dnbdmr/67key-hardware/layout/keyboard-layout.png

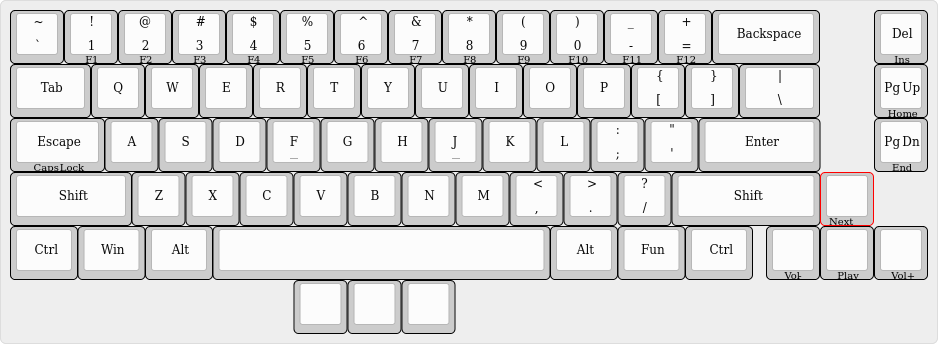
layout/keyboard-layout.png
