dnbdmr/67key-hardware/layout/keyboard-layout_details.png

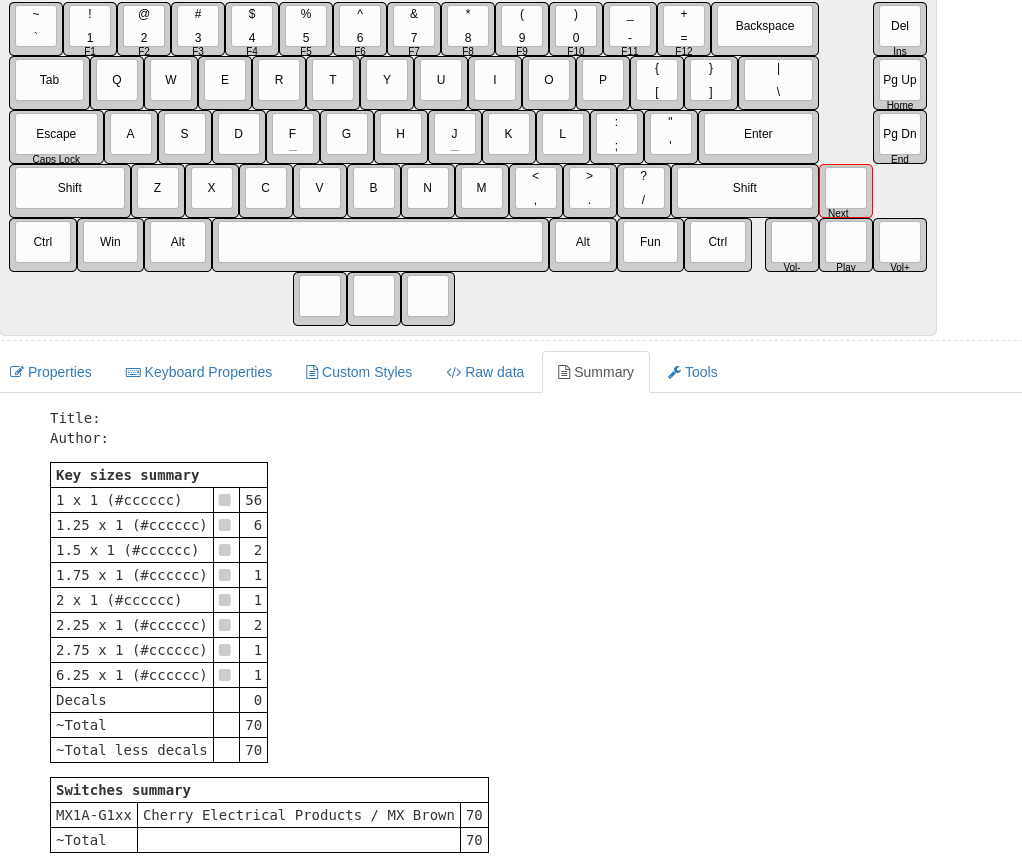
layout/keyboard-layout_details.png
