dnbdmr/67key-hardware/67keys-trackpoint.kicad_pcb

## KiCad design 67keys-trackpoint.kicad_pcb (2020-06-23)

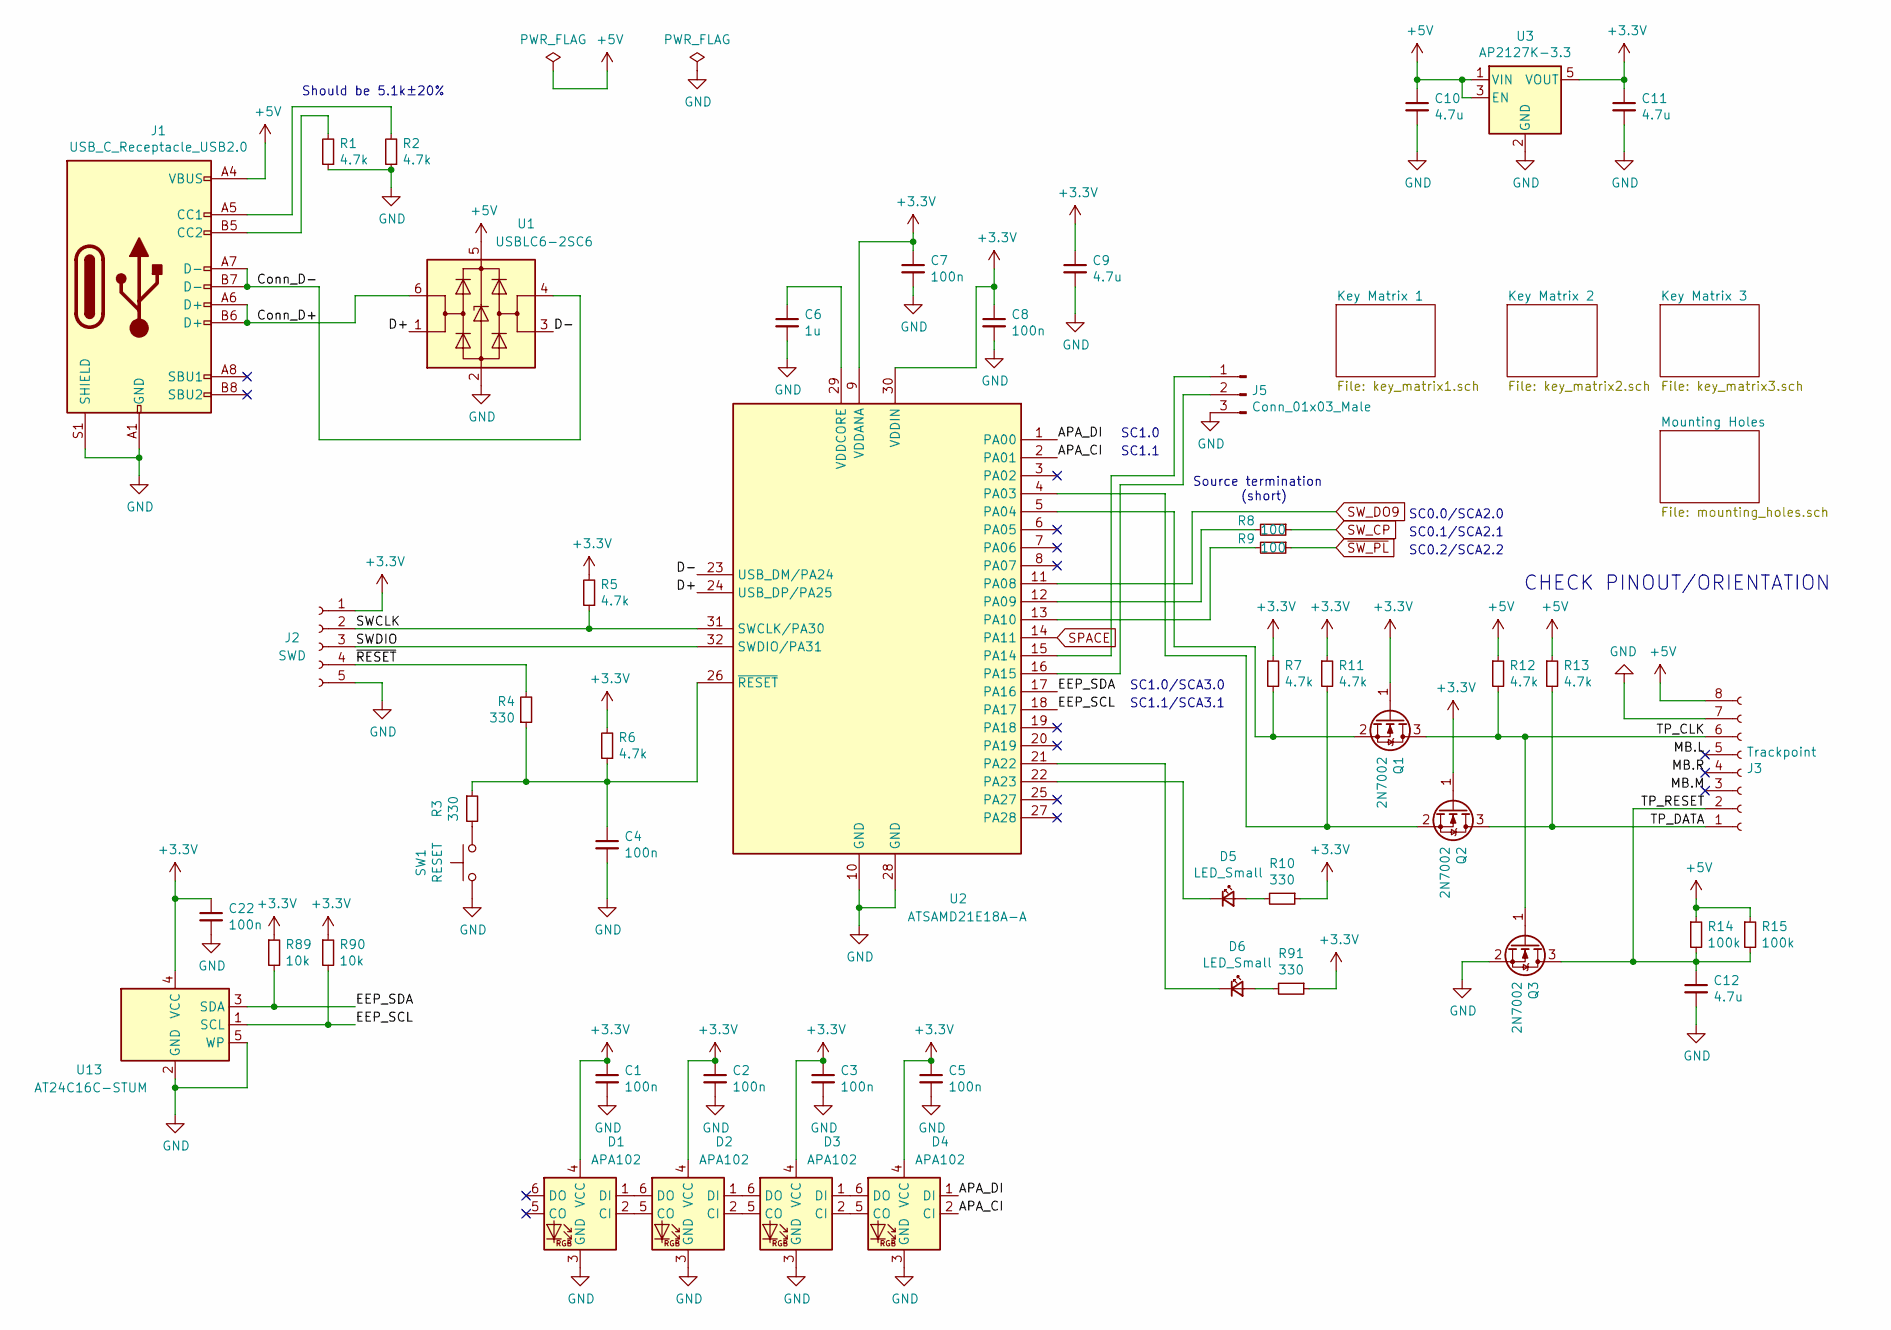
[picture p3: schematic 67keys-trackpoint.sch, 67 Keyboard with Trackpoint]

Parts:
C1, C2, C3, C4, C5, C7, C8, C22: 100n; C_0603_1608Metric_Pad1.05x0.95mm_HandSolder
C6: 1u; C_0603_1608Metric_Pad1.05x0.95mm_HandSolder
C9, C10, C11, C12: 4.7u; C_0603_1608Metric_Pad1.05x0.95mm_HandSolder
D1, D2, D3, D4: APA102; LED_RGB_5050-6
D5, D6: LED_Small; LED_0805_2012Metric_Pad1.15x1.40mm_HandSolder
J1: USB_C_Receptacle_USB2.0; USB_C_Receptacle_GCT_USB4085
J2: SWD; PinHeader_1x05_P2.54mm_Vertical
J3: Trackpoint; TE_84952-8_1x08-1MP_P1.0mm_Horizontal
J5: Conn_01x03_Male; PinHeader_1x03_P2.54mm_Vertical
Q1, Q2, Q3: 2N7002; SOT-23
R1, R2, R5, R6, R7, R11, R12, R13: 4.7k; R_0603_1608Metric_Pad1.05x0.95mm_HandSolder
R3, R4, R10, R91: 330; R_0603_1608Metric_Pad1.05x0.95mm_HandSolder
R8, R9: 100; R_0603_1608Metric_Pad1.05x0.95mm_HandSolder
R14, R15: 100k; R_0603_1608Metric_Pad1.05x0.95mm_HandSolder
R89, R90: 10k; R_0603_1608Metric_Pad1.05x0.95mm_HandSolder
SW1: RESET; SW_SPST_TL3305A
U1: USBLC6-2SC6; SOT-23-6
U2: ATSAMD21E18A-A; TQFP-32_7x7mm_P0.8mm
U3: AP2127K-3.3; SOT-23-5
U13: AT24C16C-STUM; SOT-23-5

Connections:
+3V3: C1.1, C2.1, C3.1, C5.1, C7.1, C8.1, C9.1, C11.1, C22.1, D1.4 (VCC), D2.4 (VCC), D3.4 (VCC), D4.4 (VCC), J2.1, Q1.1 (G), Q2.1 (G), R5.2, R6.2, R7.1, R10.1, R11.1, R89.1, R90.1, R91.1, U2.9 (VDDANA), U2.30 (VDDIN), U3.5 (VOUT), U13.4 (VCC); also elsewhere on the board
+5V: C10.1, J1.A4 (VBUS), J1.A9 (VBUS), J1.B4 (VBUS), J1.B9 (VBUS), J3.8, R12.1, R13.1, R14.1, R15.1, U1.5 (VBUS), U3.1 (VIN), U3.3 (EN)
/APA_CI: D4.2 (CI), U2.2 (PA01)
/APA_DI: D4.1 (DI), U2.1 (PA00)
/Conn_D+: J1.A6 (D+), J1.B6 (D+), U1.6 (I/O1)
/Conn_D-: J1.A7 (D-), J1.B7 (D-), U1.4 (I/O2)
/D+: U1.1 (I/O1), U2.24 (USB_DP/PA25)
/D-: U1.3 (I/O2), U2.23 (USB_DM/PA24)
/EEP_SCL: R90.2, U2.18 (PA17), U13.1 (SCL)
/EEP_SDA: R89.2, U2.17 (PA16), U13.3 (SDA)
/SWCLK: J2.2, R5.1, U2.31 (SWCLK/PA30)
/SWDIO: J2.3, U2.32 (SWDIO/PA31)
/TP_CLK: J3.6, Q1.3 (D), Q3.1 (G), R12.2
/TP_DATA: J3.1, Q2.3 (D), R13.2
/TP_RESET: C12.1, J3.2, Q3.3 (D), R14.2, R15.2
/~RESET: J2.4, R4.2
GND: C1.2, C2.2, C3.2, C4.2, C5.2, C6.2, C7.2, C8.2, C9.2, C10.2, C11.2, C12.2, C22.2, D1.3 (GND), D2.3 (GND), D3.3 (GND), D4.3 (GND), J1.A1 (GND), J1.A12 (GND), J1.B1 (GND), J1.B12 (GND), J1.S1 (SHIELD), J2.5, J3.7, J5.3, Q3.2 (S), R1.1, R2.1, SW1.1, U1.2 (GND), U2.10 (GND), U2.28 (GND), U3.2 (GND), U13.2 (GND), U13.5 (WP); also elsewhere on the board
unnamed: C4.1, R3.1, R4.1, R6.1, U2.26 (~RESET)
unnamed: C6.1, U2.29 (VDDCORE)
unnamed: D1.1 (DI), D2.6 (DO)
unnamed: D1.2 (CI), D2.5 (CO)
unnamed: D2.1 (DI), D3.6 (DO)
unnamed: D2.2 (CI), D3.5 (CO)
unnamed: D3.1 (DI), D4.6 (DO)
unnamed: D3.2 (CI), D4.5 (CO)
unnamed: D5.1 (K), U2.22 (PA23)
unnamed: D5.2 (A), R10.2
unnamed: D6.1 (K), U2.21 (PA22)
unnamed: D6.2 (A), R91.2
unnamed: J1.A5 (CC1), R2.2
unnamed: J1.B5 (CC2), R1.2
unnamed: J5.1, U2.15 (PA14)
unnamed: J5.2, U2.16 (PA15)
unnamed: Q1.2 (S), R7.2, U2.5 (PA04)
unnamed: Q2.2 (S), R11.2, U2.4 (PA03)
unnamed: R3.2, SW1.2
unnamed: R8.2, U2.12 (PA09)
unnamed: R9.2, U2.13 (PA10)
SPACE: U2.14 (PA11); also elsewhere on the board
SW_CP: R8.1; also elsewhere on the board
SW_DO9: U2.11 (PA08); also elsewhere on the board
~SW_PL: R9.1; also elsewhere on the board

Notes on the sheet:
CHECK PINOUT/ORIENTATION
Should be 5.1k±20%
Source termination (short)
SC1.0
SC1.1
SC0.1/SCA2.1
SC0.2/SCA2.2
SC1.1/SCA3.1
SC1.0/SCA3.0
SC0.0/SCA2.0

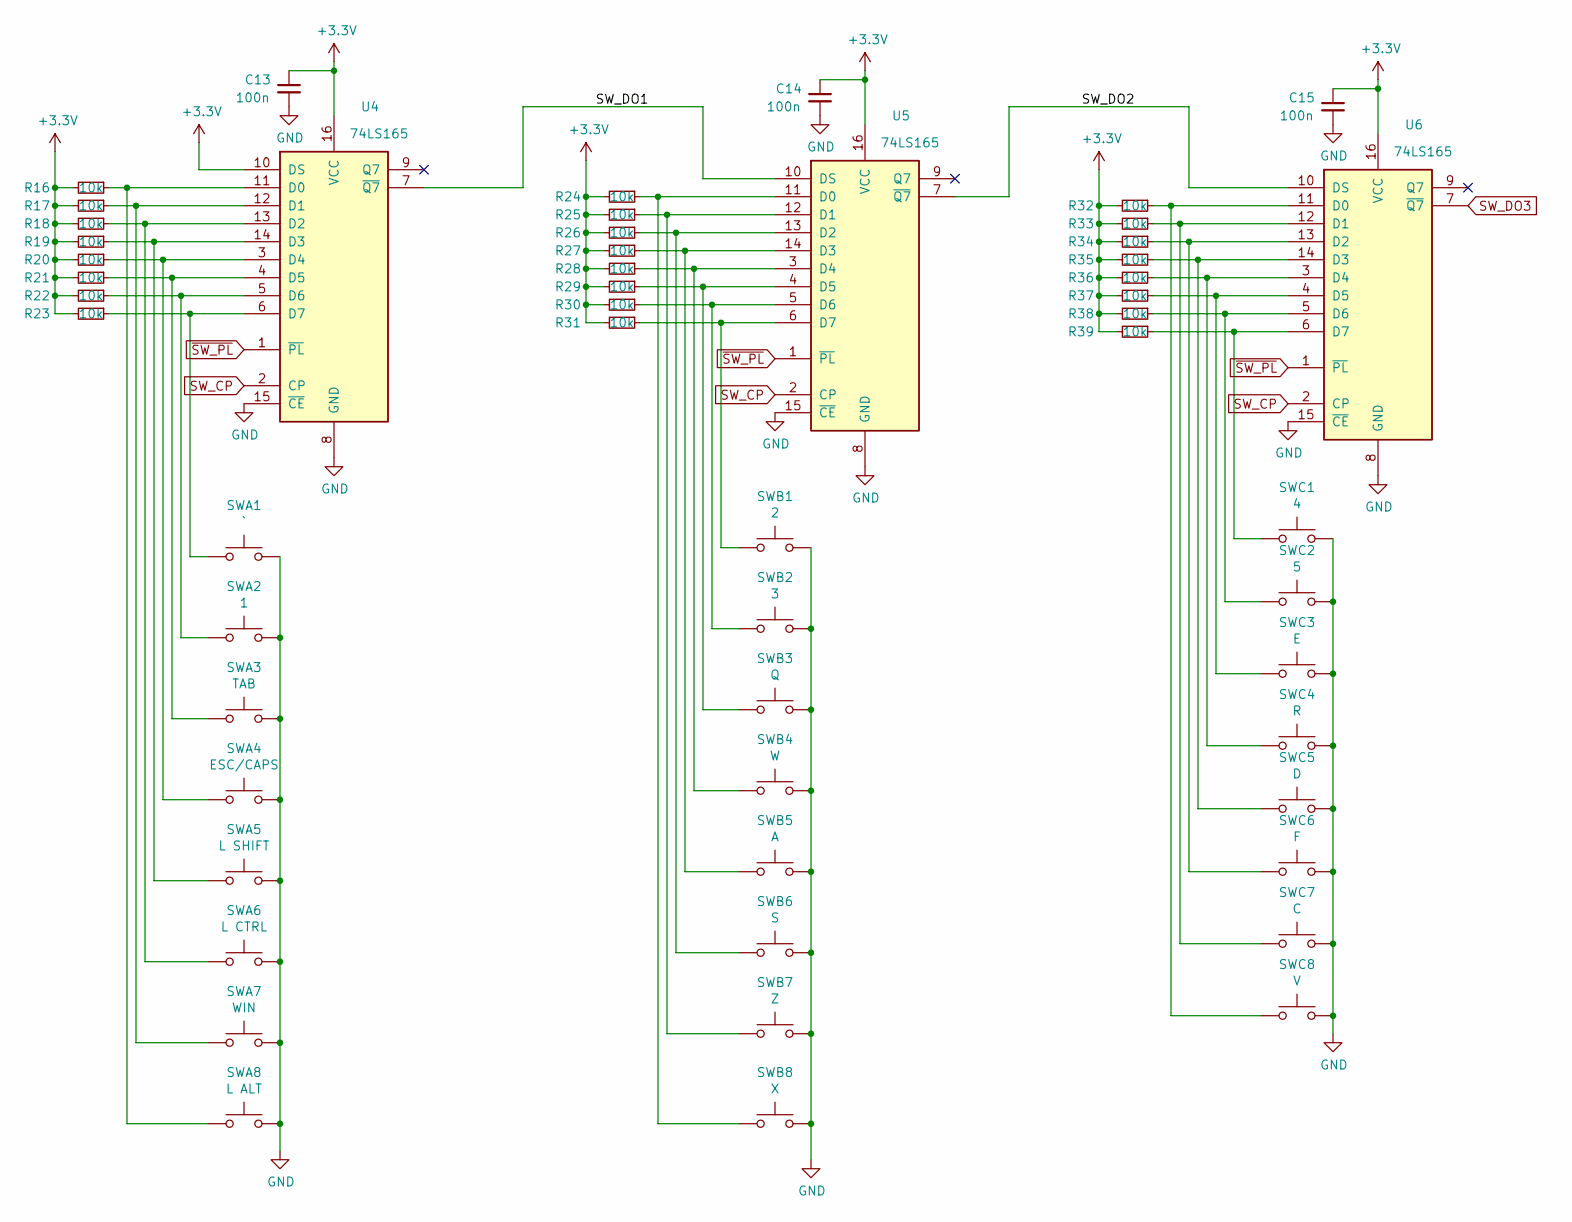
[picture p4: schematic key_matrix1.sch, 67 Keyboard with Trackpoint]

Parts:
C13, C14, C15: 100n; C_0603_1608Metric_Pad1.05x0.95mm_HandSolder
R16, R17, R18, R19, R20, R21, R22, R23, R24, R25, R26, R27, R28, R29, R30, R31, R32, R33, R34, R35, R36, R37, R38, R39: 10k; R_0603_1608Metric_Pad1.05x0.95mm_HandSolder
SWA1: `; SW_Cherry_MX_1.00u_PCB
SWA2: 1; SW_Cherry_MX_1.00u_PCB
SWA3: TAB; SW_Cherry_MX_1.50u_PCB
SWA4: ESC/CAPS; SW_Cherry_MX_1.75u_PCB
SWA5: L SHIFT; SW_Cherry_MX_2.25u_PCB
SWA6: L CTRL; SW_Cherry_MX_1.25u_PCB
SWA7: WIN; SW_Cherry_MX_1.25u_PCB
SWA8: L ALT; SW_Cherry_MX_1.25u_PCB
SWB1: 2; SW_Cherry_MX_1.00u_PCB
SWB2: 3; SW_Cherry_MX_1.00u_PCB
SWB3: Q; SW_Cherry_MX_1.00u_PCB
SWB4: W; SW_Cherry_MX_1.00u_PCB
SWB5: A; SW_Cherry_MX_1.00u_PCB
SWB6: S; SW_Cherry_MX_1.00u_PCB
SWB7: Z; SW_Cherry_MX_1.00u_PCB
SWB8: X; SW_Cherry_MX_1.00u_PCB
SWC1: 4; SW_Cherry_MX_1.00u_PCB
SWC2: 5; SW_Cherry_MX_1.00u_PCB
SWC3: E; SW_Cherry_MX_1.00u_PCB
SWC4: R; SW_Cherry_MX_1.00u_PCB
SWC5: D; SW_Cherry_MX_1.00u_PCB
SWC6: F; SW_Cherry_MX_1.00u_PCB
SWC7: C; SW_Cherry_MX_1.00u_PCB
SWC8: V; SW_Cherry_MX_1.00u_PCB
U4, U5, U6: 74LS165; TSSOP-16_4.4x5mm_P0.65mm

Connections:
+3V3: C13.1, C14.1, C15.1, R16.2, R17.2, R18.2, R19.2, R20.2, R21.2, R22.2, R23.2, R24.2, R25.2, R26.2, R27.2, R28.2, R29.2, R30.2, R31.2, R32.2, R33.2, R34.2, R35.2, R36.2, R37.2, R38.2, R39.2, U4.10 (DS), U4.16 (VCC), U5.16 (VCC), U6.16 (VCC); also elsewhere on the board
/Key Matrix 1/SW_DO1: U4.7 (~Q7), U5.10 (DS)
/Key Matrix 1/SW_DO2: U5.7 (~Q7), U6.10 (DS)
GND: C13.2, C14.2, C15.2, SWA1.2, SWA2.2, SWA3.2, SWA4.2, SWA5.2, SWA6.2, SWA7.2, SWA8.2, SWB1.2, SWB2.2, SWB3.2, SWB4.2, SWB5.2, SWB6.2, SWB7.2, SWB8.2, SWC1.2, SWC2.2, SWC3.2, SWC4.2, SWC5.2, SWC6.2, SWC7.2, SWC8.2, U4.8 (GND), U4.15 (~CE), U5.8 (GND), U5.15 (~CE), U6.8 (GND), U6.15 (~CE); also elsewhere on the board
unnamed: R16.1, SWA8.1, U4.11 (D0)
unnamed: R17.1, SWA7.1, U4.12 (D1)
unnamed: R18.1, SWA6.1, U4.13 (D2)
unnamed: R19.1, SWA5.1, U4.14 (D3)
unnamed: R20.1, SWA4.1, U4.3 (D4)
unnamed: R21.1, SWA3.1, U4.4 (D5)
unnamed: R22.1, SWA2.1, U4.5 (D6)
unnamed: R23.1, SWA1.1, U4.6 (D7)
unnamed: R24.1, SWB8.1, U5.11 (D0)
unnamed: R25.1, SWB7.1, U5.12 (D1)
unnamed: R26.1, SWB6.1, U5.13 (D2)
unnamed: R27.1, SWB5.1, U5.14 (D3)
unnamed: R28.1, SWB4.1, U5.3 (D4)
unnamed: R29.1, SWB3.1, U5.4 (D5)
unnamed: R30.1, SWB2.1, U5.5 (D6)
unnamed: R31.1, SWB1.1, U5.6 (D7)
unnamed: R32.1, SWC8.1, U6.11 (D0)
unnamed: R33.1, SWC7.1, U6.12 (D1)
unnamed: R34.1, SWC6.1, U6.13 (D2)
unnamed: R35.1, SWC5.1, U6.14 (D3)
unnamed: R36.1, SWC4.1, U6.3 (D4)
unnamed: R37.1, SWC3.1, U6.4 (D5)
unnamed: R38.1, SWC2.1, U6.5 (D6)
unnamed: R39.1, SWC1.1, U6.6 (D7)
SW_CP: U4.2 (CP), U5.2 (CP), U6.2 (CP); also elsewhere on the board
SW_DO3: U6.7 (~Q7); also elsewhere on the board
~SW_PL: U4.1 (~PL), U5.1 (~PL), U6.1 (~PL); also elsewhere on the board

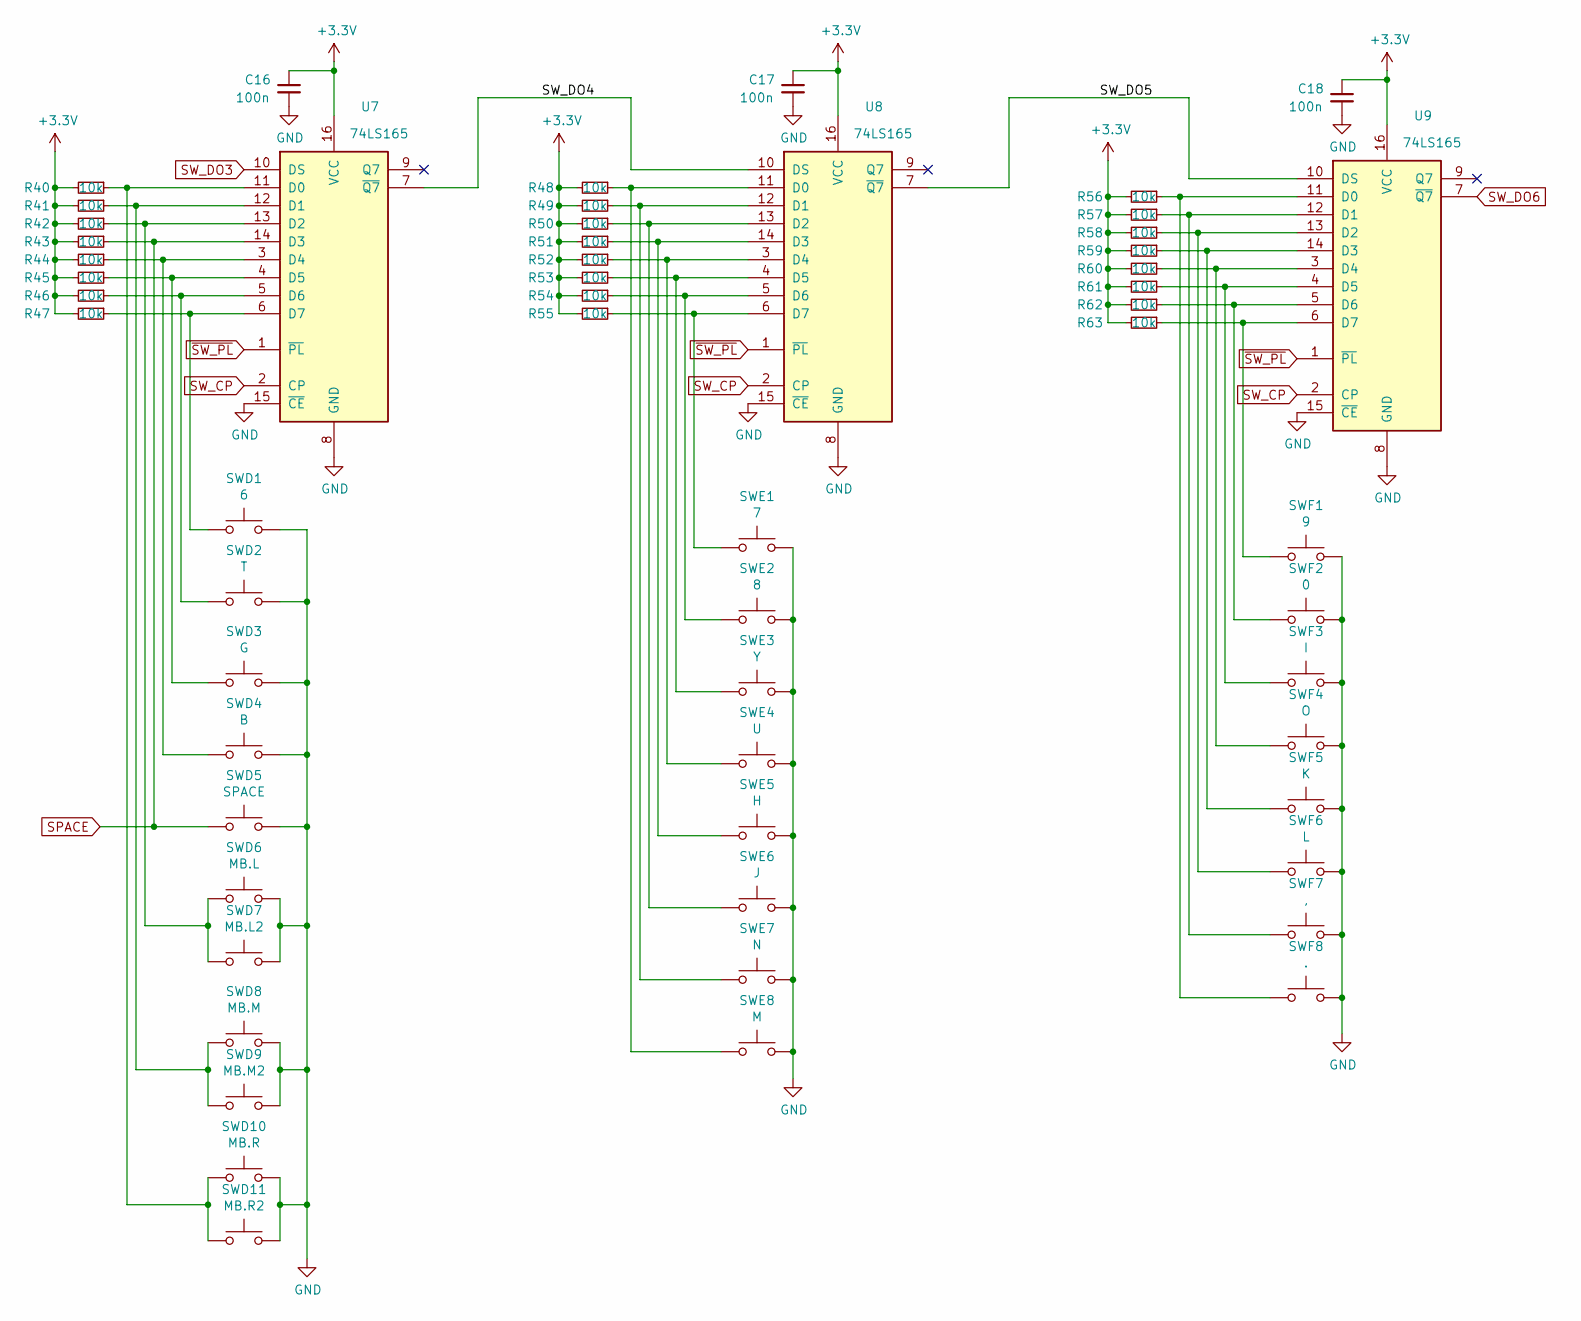
[picture p5: schematic key_matrix2.sch, 67 Keyboard with Trackpoint]

Parts:
C16, C17, C18: 100n; C_0603_1608Metric_Pad1.05x0.95mm_HandSolder
R40, R41, R42, R43, R44, R45, R46, R47, R48, R49, R50, R51, R52, R53, R54, R55, R56, R57, R58, R59, R60, R61, R62, R63: 10k; R_0603_1608Metric_Pad1.05x0.95mm_HandSolder
SWD1: 6; SW_Cherry_MX_1.00u_PCB
SWD2: T; SW_Cherry_MX_1.00u_PCB
SWD3: G; SW_Cherry_MX_1.00u_PCB
SWD4: B; SW_Cherry_MX_1.00u_PCB
SWD5: SPACE; SW_Cherry_MX_6.25u_PCB
SWD6: MB.L; SW_Cherry_MX_1.00u_PCB
SWD7: MB.L2; SW_Tactile_SPST_Angled_PTS645Vx58-2LFS
SWD8: MB.M; SW_Cherry_MX_1.00u_PCB
SWD9: MB.M2; SW_Tactile_SPST_Angled_PTS645Vx58-2LFS
SWD10: MB.R; SW_Cherry_MX_1.00u_PCB
SWD11: MB.R2; SW_Tactile_SPST_Angled_PTS645Vx58-2LFS
SWE1: 7; SW_Cherry_MX_1.00u_PCB
SWE2: 8; SW_Cherry_MX_1.00u_PCB
SWE3: Y; SW_Cherry_MX_1.00u_PCB
SWE4: U; SW_Cherry_MX_1.00u_PCB
SWE5: H; SW_Cherry_MX_1.00u_PCB
SWE6: J; SW_Cherry_MX_1.00u_PCB
SWE7: N; SW_Cherry_MX_1.00u_PCB
SWE8: M; SW_Cherry_MX_1.00u_PCB
SWF1: 9; SW_Cherry_MX_1.00u_PCB
SWF2: 0; SW_Cherry_MX_1.00u_PCB
SWF3: I; SW_Cherry_MX_1.00u_PCB
SWF4: O; SW_Cherry_MX_1.00u_PCB
SWF5: K; SW_Cherry_MX_1.00u_PCB
SWF6: L; SW_Cherry_MX_1.00u_PCB
SWF7: ,; SW_Cherry_MX_1.00u_PCB
SWF8: .; SW_Cherry_MX_1.00u_PCB
U7, U8, U9: 74LS165; TSSOP-16_4.4x5mm_P0.65mm

Connections:
+3V3: C16.1, C17.1, C18.1, R40.2, R41.2, R42.2, R43.2, R44.2, R45.2, R46.2, R47.2, R48.2, R49.2, R50.2, R51.2, R52.2, R53.2, R54.2, R55.2, R56.2, R57.2, R58.2, R59.2, R60.2, R61.2, R62.2, R63.2, U7.16 (VCC), U8.16 (VCC), U9.16 (VCC); also elsewhere on the board
/Key Matrix 2/SW_DO4: U7.7 (~Q7), U8.10 (DS)
/Key Matrix 2/SW_DO5: U8.7 (~Q7), U9.10 (DS)
GND: C16.2, C17.2, C18.2, SWD1.2, SWD2.2, SWD3.2, SWD4.2, SWD5.2, SWD6.2, SWD7.2, SWD8.2, SWD9.2, SWD10.2, SWD11.2, SWE1.2, SWE2.2, SWE3.2, SWE4.2, SWE5.2, SWE6.2, SWE7.2, SWE8.2, SWF1.2, SWF2.2, SWF3.2, SWF4.2, SWF5.2, SWF6.2, SWF7.2, SWF8.2, U7.8 (GND), U7.15 (~CE), U8.8 (GND), U8.15 (~CE), U9.8 (GND), U9.15 (~CE); also elsewhere on the board
unnamed: R40.1, SWD10.1, SWD11.1, U7.11 (D0)
unnamed: R41.1, SWD8.1, SWD9.1, U7.12 (D1)
unnamed: R42.1, SWD6.1, SWD7.1, U7.13 (D2)
unnamed: R44.1, SWD4.1, U7.3 (D4)
unnamed: R45.1, SWD3.1, U7.4 (D5)
unnamed: R46.1, SWD2.1, U7.5 (D6)
unnamed: R47.1, SWD1.1, U7.6 (D7)
unnamed: R48.1, SWE8.1, U8.11 (D0)
unnamed: R49.1, SWE7.1, U8.12 (D1)
unnamed: R50.1, SWE6.1, U8.13 (D2)
unnamed: R51.1, SWE5.1, U8.14 (D3)
unnamed: R52.1, SWE4.1, U8.3 (D4)
unnamed: R53.1, SWE3.1, U8.4 (D5)
unnamed: R54.1, SWE2.1, U8.5 (D6)
unnamed: R55.1, SWE1.1, U8.6 (D7)
unnamed: R56.1, SWF8.1, U9.11 (D0)
unnamed: R57.1, SWF7.1, U9.12 (D1)
unnamed: R58.1, SWF6.1, U9.13 (D2)
unnamed: R59.1, SWF5.1, U9.14 (D3)
unnamed: R60.1, SWF4.1, U9.3 (D4)
unnamed: R61.1, SWF3.1, U9.4 (D5)
unnamed: R62.1, SWF2.1, U9.5 (D6)
unnamed: R63.1, SWF1.1, U9.6 (D7)
SPACE: R43.1, SWD5.1, U7.14 (D3); also elsewhere on the board
SW_CP: U7.2 (CP), U8.2 (CP), U9.2 (CP); also elsewhere on the board
SW_DO3: U7.10 (DS); also elsewhere on the board
SW_DO6: U9.7 (~Q7); also elsewhere on the board
~SW_PL: U7.1 (~PL), U8.1 (~PL), U9.1 (~PL); also elsewhere on the board

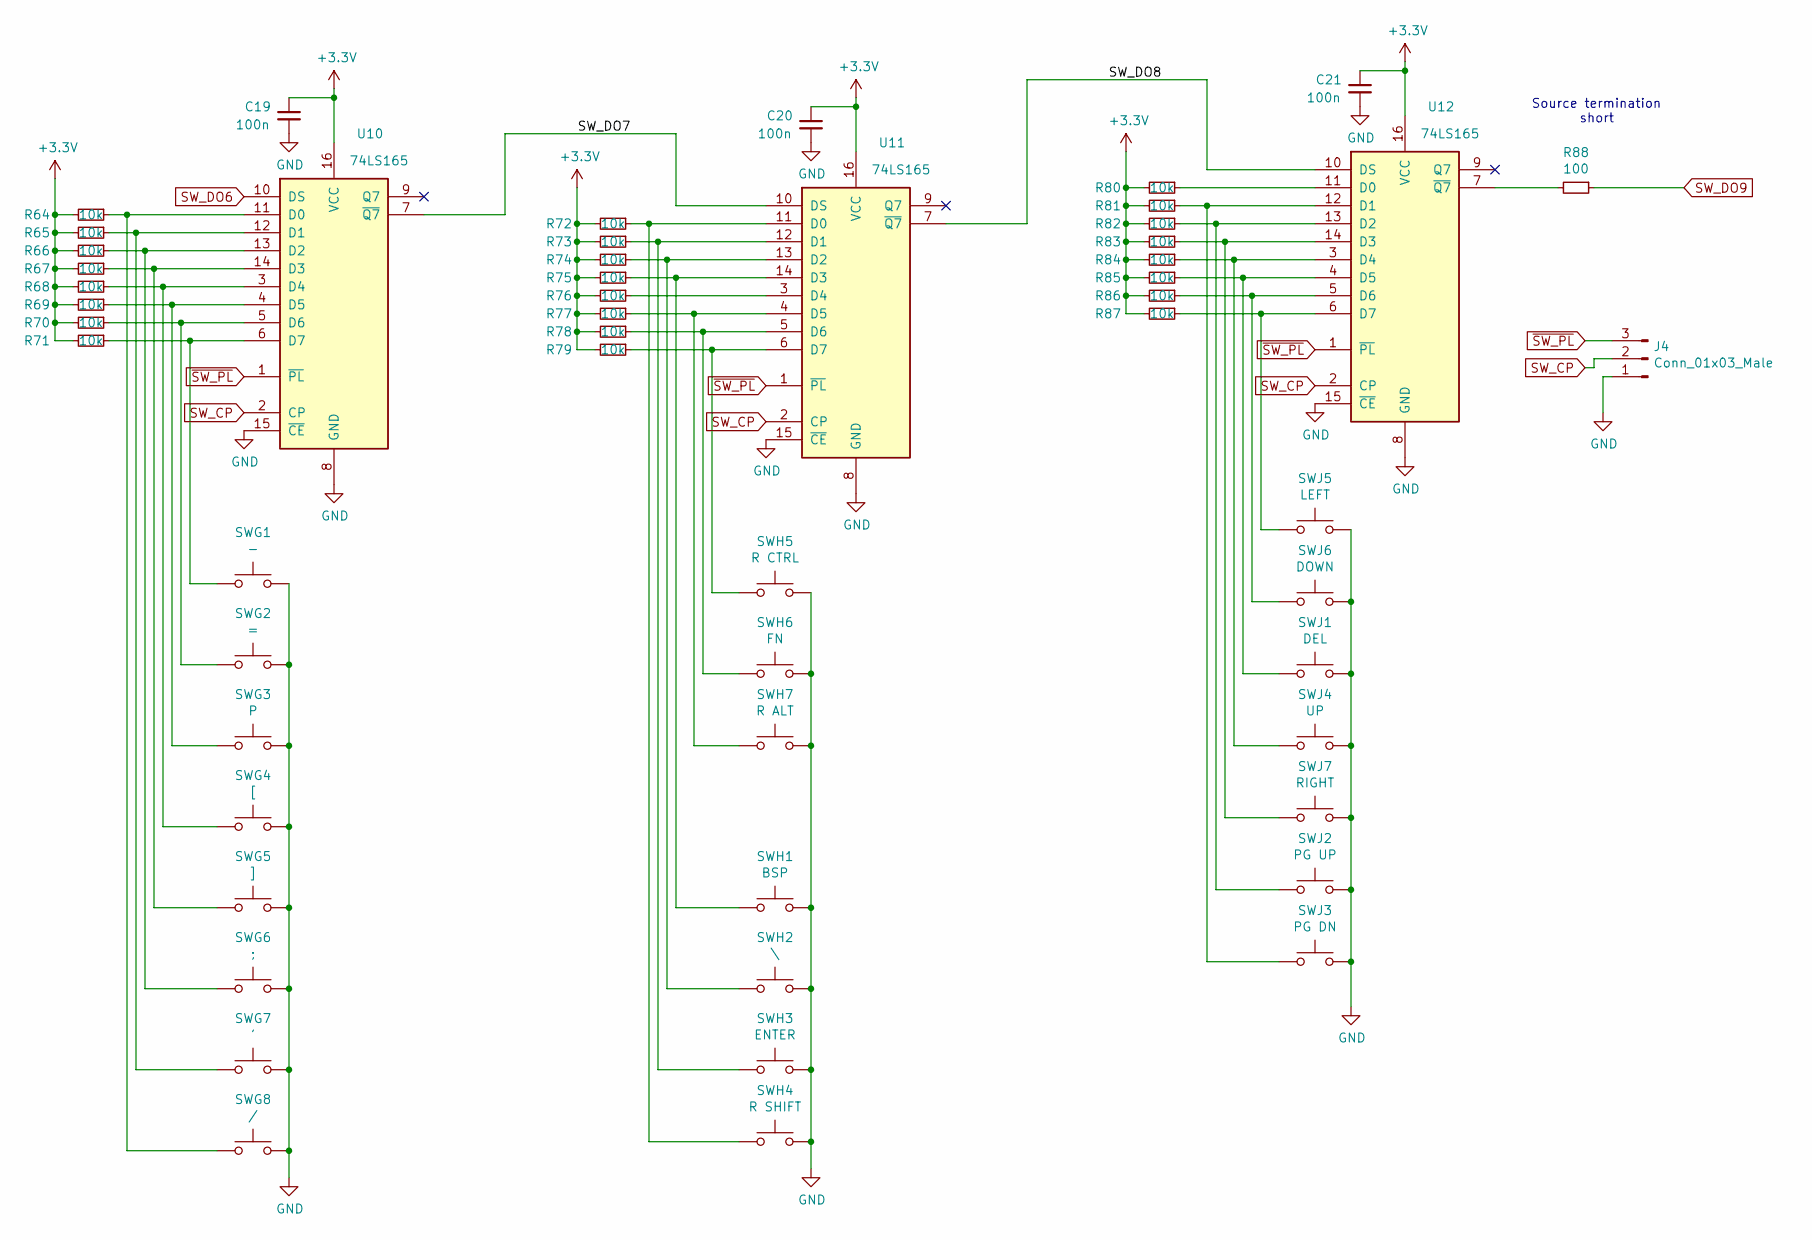
[picture p6: schematic key_matrix3.sch, 67 Keyboard with Trackpoint]

Parts:
C19, C20, C21: 100n; C_0603_1608Metric_Pad1.05x0.95mm_HandSolder
J4: Conn_01x03_Male; PinHeader_1x03_P2.54mm_Vertical
R64, R65, R66, R67, R68, R69, R70, R71, R72, R73, R74, R75, R76, R77, R78, R79, R80, R81, R82, R83, R84, R85, R86, R87: 10k; R_0603_1608Metric_Pad1.05x0.95mm_HandSolder
R88: 100; R_0603_1608Metric_Pad1.05x0.95mm_HandSolder
SWG1: -; SW_Cherry_MX_1.00u_PCB
SWG2: =; SW_Cherry_MX_1.00u_PCB
SWG3: P; SW_Cherry_MX_1.00u_PCB
SWG4: [; SW_Cherry_MX_1.00u_PCB
SWG5: ]; SW_Cherry_MX_1.00u_PCB
SWG6: ;; SW_Cherry_MX_1.00u_PCB
SWG7: '; SW_Cherry_MX_1.00u_PCB
SWG8: /; SW_Cherry_MX_1.00u_PCB
SWH1: BSP; SW_Cherry_MX_2.00u_PCB
SWH2: \\; SW_Cherry_MX_1.50u_PCB
SWH3: ENTER; SW_Cherry_MX_2.25u_PCB
SWH4: R SHIFT; SW_Cherry_MX_2.75u_PCB
SWH5: R CTRL; SW_Cherry_MX_1.25u_PCB
SWH6: FN; SW_Cherry_MX_1.25u_PCB
SWH7: R ALT; SW_Cherry_MX_1.25u_PCB
SWJ1: DEL; SW_Cherry_MX_1.00u_PCB
SWJ2: PG UP; SW_Cherry_MX_1.00u_PCB
SWJ3: PG DN; SW_Cherry_MX_1.00u_PCB
SWJ4: UP; SW_Cherry_MX_1.00u_PCB
SWJ5: LEFT; SW_Cherry_MX_1.00u_PCB
SWJ6: DOWN; SW_Cherry_MX_1.00u_PCB
SWJ7: RIGHT; SW_Cherry_MX_1.00u_PCB
U10, U11, U12: 74LS165; TSSOP-16_4.4x5mm_P0.65mm

Connections:
+3V3: C19.1, C20.1, C21.1, R64.2, R65.2, R66.2, R67.2, R68.2, R69.2, R70.2, R71.2, R72.2, R73.2, R74.2, R75.2, R76.2, R77.2, R78.2, R79.2, R80.2, R81.2, R82.2, R83.2, R84.2, R85.2, R86.2, R87.2, U10.16 (VCC), U11.16 (VCC), U12.16 (VCC); also elsewhere on the board
/Key Matrix 3/SW_DO7: U10.7 (~Q7), U11.10 (DS)
/Key Matrix 3/SW_DO8: U11.7 (~Q7), U12.10 (DS)
GND: C19.2, C20.2, C21.2, J4.1, SWG1.2, SWG2.2, SWG3.2, SWG4.2, SWG5.2, SWG6.2, SWG7.2, SWG8.2, SWH1.2, SWH2.2, SWH3.2, SWH4.2, SWH5.2, SWH6.2, SWH7.2, SWJ1.2, SWJ2.2, SWJ3.2, SWJ4.2, SWJ5.2, SWJ6.2, SWJ7.2, U10.8 (GND), U10.15 (~CE), U11.8 (GND), U11.15 (~CE), U12.8 (GND), U12.15 (~CE); also elsewhere on the board
unnamed: R64.1, SWG8.1, U10.11 (D0)
unnamed: R65.1, SWG7.1, U10.12 (D1)
unnamed: R66.1, SWG6.1, U10.13 (D2)
unnamed: R67.1, SWG5.1, U10.14 (D3)
unnamed: R68.1, SWG4.1, U10.3 (D4)
unnamed: R69.1, SWG3.1, U10.4 (D5)
unnamed: R70.1, SWG2.1, U10.5 (D6)
unnamed: R71.1, SWG1.1, U10.6 (D7)
unnamed: R72.1, SWH4.1, U11.11 (D0)
unnamed: R73.1, SWH3.1, U11.12 (D1)
unnamed: R74.1, SWH2.1, U11.13 (D2)
unnamed: R75.1, SWH1.1, U11.14 (D3)
unnamed: R76.1, U11.3 (D4)
unnamed: R77.1, SWH7.1, U11.4 (D5)
unnamed: R78.1, SWH6.1, U11.5 (D6)
unnamed: R79.1, SWH5.1, U11.6 (D7)
unnamed: R80.1, U12.11 (D0)
unnamed: R81.1, SWJ3.1, U12.12 (D1)
unnamed: R82.1, SWJ2.1, U12.13 (D2)
unnamed: R83.1, SWJ7.1, U12.14 (D3)
unnamed: R84.1, SWJ4.1, U12.3 (D4)
unnamed: R85.1, SWJ1.1, U12.4 (D5)
unnamed: R86.1, SWJ6.1, U12.5 (D6)
unnamed: R87.1, SWJ5.1, U12.6 (D7)
unnamed: R88.2, U12.7 (~Q7)
SW_CP: J4.2, U10.2 (CP), U11.2 (CP), U12.2 (CP); also elsewhere on the board
SW_DO6: U10.10 (DS); also elsewhere on the board
SW_DO9: R88.1; also elsewhere on the board
~SW_PL: J4.3, U10.1 (~PL), U11.1 (~PL), U12.1 (~PL); also elsewhere on the board

Notes on the sheet:
Source termination short

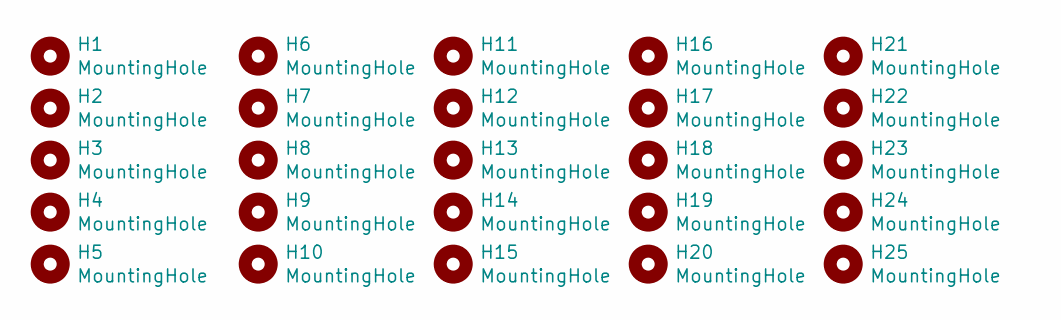
[picture p7: schematic mounting_holes.sch, 67 Keyboard with Trackpoint]

Parts:
H1, H2, H3, H4, H5, H6, H7, H8, H9, H10, H11, H12, H13, H14, H15, H16, H17, H18, H19, H20, H21, H22, H23, H24, H25: MountingHole; MountingHole_2.2mm_M2

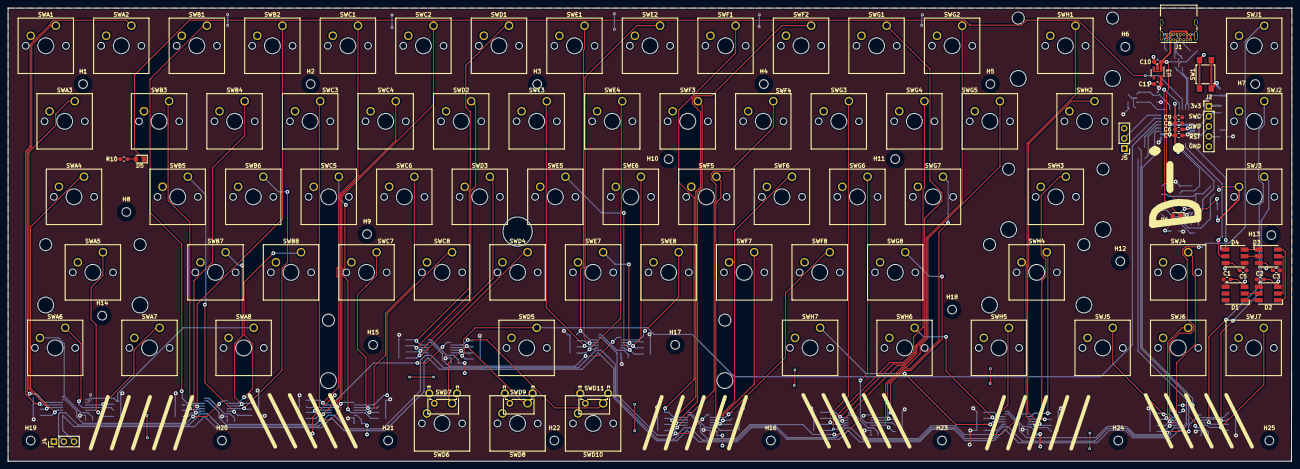
[picture p8: board 67keys-trackpoint.kicad_pcb from above]

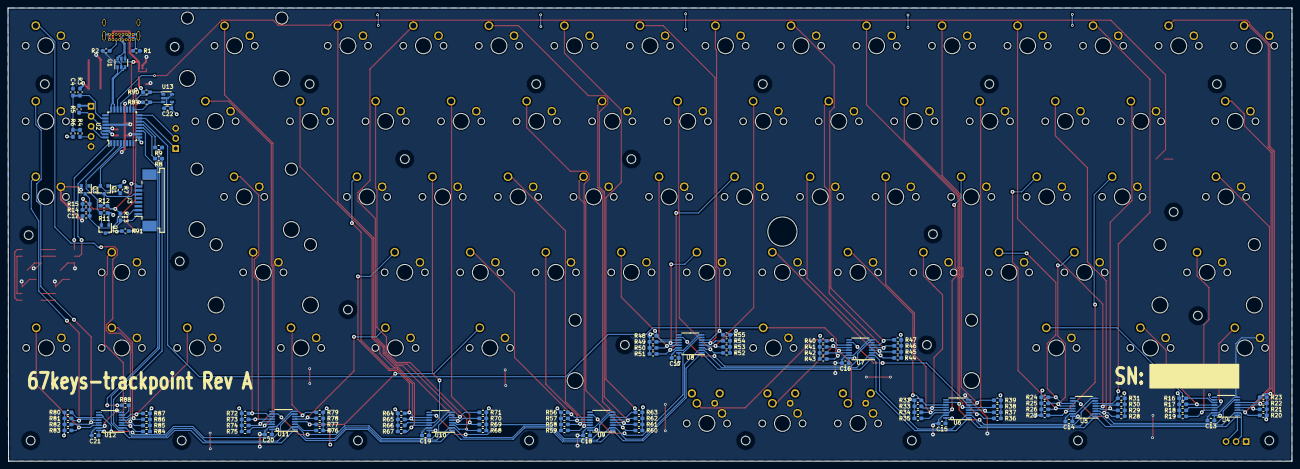
[picture p9: board 67keys-trackpoint.kicad_pcb from below]

Board: 2 copper layers, 323.9 x 114.3 mm, 239 parts (118 on the bottom side), 122 nets.
