dnbdmr/67key-hardware/(commit log)

2020-06-10 Initial commit. Mostly complete.
    [67keys-trackpoint.kicad_pcb, 67keys-trackpoint.sch, key_matrix.sch]
2020-06-10 Added bypass caps to Dotstars
    [67keys-trackpoint.sch]
2020-06-11 Added check note, removed sch-bak from index
    [67keys-trackpoint.sch]
2020-06-11 Change symbol for USB connnector
    [67keys-trackpoint.sch]
2020-06-12 Run DotStart at 3.3V, add notes
    [67keys-trackpoint.sch]
2020-06-12 Completed usb-c
    [67keys-trackpoint.sch]
2020-06-12 Annotated, key matrix named after columns/rows
    [67keys-trackpoint.sch, key_matrix.sch]
2020-06-12 Assigned footprints
    [67keys-trackpoint.sch, key_matrix.sch]
2020-06-12 Layout: board outline, keys, some diodes
    [67keys-trackpoint.kicad_pcb]
2020-06-12 Partial layout
    [67keys-trackpoint.kicad_pcb, 67keys-trackpoint.sch, key_matrix.sch]
2020-06-13 Almost fully routed, total mess.
    - 10x7 matrix, shuffled around
    [67keys-trackpoint.kicad_pcb, 67keys-trackpoint.sch]
2020-06-13 Changed to 14x5 matrix, removed LED
    [67keys-trackpoint.kicad_pcb, 67keys-trackpoint.sch, key_matrix.sch]
2020-06-13 Laid out most diodes. Switched Row 4 and tpclk
    [67keys-trackpoint.kicad_pcb, 67keys-trackpoint.sch]
2020-06-13 Moved and named APA lines
    [67keys-trackpoint.kicad_pcb, 67keys-trackpoint.sch]
2020-06-13 Updated some design rules
    [67keys-trackpoint.kicad_pcb]
2020-06-13 Routed. Very ugly.
    [67keys-trackpoint.kicad_pcb]
2020-06-13 Added cuttable jumper to SWD line
    [67keys-trackpoint.kicad_pcb, 67keys-trackpoint.sch]
2020-06-13 Added notes
    [67keys-trackpoint.kicad_pcb, 67keys-trackpoint.sch]
2020-06-14 Added tp hole, notes, started footprint
    [67keys-trackpoint.kicad_pcb]
2020-06-14 Added alternat footprints for mouse buttons
    [67keys-trackpoint.kicad_pcb, key_matrix.sch]
2020-06-14 Added some mounting holes
    [67keys-trackpoint.kicad_pcb]
2020-06-14 Moved some references
    [67keys-trackpoint.kicad_pcb]
2020-06-15 Started matrix schematic
    [67keys-trackpoint.kicad_pcb, 67keys-trackpoint.sch, key_matrix.sch]
2020-06-15 Cleared tracks from pcm
    [67keys-trackpoint.kicad_pcb]
2020-06-15 Split matrix schematic
    [67keys-trackpoint.kicad_pcb, 67keys-trackpoint.sch, key_matrix1.sch, key_matrix2.sch, key_matrix3.sch]
2020-06-16 Laid out schematic keys
    [67keys-trackpoint.kicad_pcb, 67keys-trackpoint.sch, key_matrix1.sch, key_matrix2.sch, key_matrix3.sch]
2020-06-17 Finished schematic
    - Laid out shift matrix
    - Added series termination resistors to shift spi
    - Changed label for TP_RESET, should be active high.
    [67keys-trackpoint.sch, key_matrix1.sch, key_matrix2.sch, key_matrix3.sch]
2020-06-17 Reannotated pcb keys according to schematic
    [67keys-trackpoint.kicad_pcb, 67keys-trackpoint.sch, key_matrix1.sch, key_matrix2.sch, key_matrix3.sch]
2020-06-17 Changed sercom texts
    [67keys-trackpoint.sch]
2020-06-19 Added eeprom.
    [67keys-trackpoint.sch]
2020-06-19 Added mounting holes to schematic
    [67keys-trackpoint.sch, key_matrix1.sch, key_matrix2.sch, key_matrix3.sch, mounting_holes.sch]
2020-06-19 Started placement
    [67keys-trackpoint.kicad_pcb]
2020-06-19 Started routing, switched TP pins
    [67keys-trackpoint.kicad_pcb, 67keys-trackpoint.sch]
2020-06-19 Routed, poorly.
    [67keys-trackpoint.kicad_pcb, key_matrix3.sch]
2020-06-19 Changed termination resistors to 100 ohm.
    [67keys-trackpoint.kicad_pcb, 67keys-trackpoint.sch, key_matrix3.sch]
2020-06-19 Changed eeprom part number
    [67keys-trackpoint.kicad_pcb, 67keys-trackpoint.sch]
2020-06-19 Moved references, updated readme
    [67keys-trackpoint.kicad_pcb]
2020-06-20 Made trackpoint virtual footprints
    [67keys-trackpoint.kicad_pcb]
2020-06-20 Mount tp module horizontally, moved mounting hole
    [67keys-trackpoint.kicad_pcb]
2020-06-20 Moved some tracks and mounting holes, clearance
    [67keys-trackpoint.kicad_pcb]
2020-06-20 Added extra pin header, some artwork
    [67keys-trackpoint.kicad_pcb, 67keys-trackpoint.sch]
2020-06-20 Re-added tp footprint
    [67keys-trackpoint.kicad_pcb]
2020-06-20 Added back board design
    [67keys-trackpoint_back_board-B_Cu.gbr, 67keys-trackpoint_back_board-B_Mask.gbr, 67keys-trackpoint_back_board-B_SilkS.gbr, 67keys-trackpoint_back_board-Edge_Cuts.gbr, 67keys-trackpoint_back_board-F_Cu.gbr, 67keys-trackpoint_back_board-F_Mask.gbr, 67keys-trackpoint_back_board-F_SilkS.gbr, 67keys-trackpoint_back_board-job.gbrjob]
2020-06-20 Locked keys and mounting holes
    [67keys-trackpoint.kicad_pcb]
2020-06-20 Tied to 3v3 first input to shift regs, U4-10
    [67keys-trackpoint.kicad_pcb, key_matrix1.sch]
2020-06-20 Added some artwork, changed a track
    [67keys-trackpoint.kicad_pcb]
2020-06-21 Redid back board
    [67keys-trackpoint.kicad_pcb, 67keys-trackpoint_back_board.kicad_pcb]
2020-06-21 Adjusted filled areas, moved led trace
    [67keys-trackpoint.kicad_pcb]
2020-06-21 Added direct line to space bar. Stitched some planes
    [67keys-trackpoint.kicad_pcb, 67keys-trackpoint.sch, key_matrix2.sch]
2020-06-21 Tweaked drawings, updated page descriptions
    [67keys-trackpoint.kicad_pcb, 67keys-trackpoint.sch, key_matrix1.sch, key_matrix2.sch, key_matrix3.sch, mounting_holes.sch]
2020-06-21 Tweaked artwork, added SN field
    [67keys-trackpoint.kicad_pcb]
2020-06-22 Clean up tracks
    [67keys-trackpoint.kicad_pcb]
2020-06-22 Shifted usb connector, removed derp
    [67keys-trackpoint.kicad_pcb]
2020-06-23 Removed fp-info-cache
    [67keys-trackpoint.sch]
2020-06-23 Made Rev A PCB
    [67keys-trackpoint-B_Cu.gbr, 67keys-trackpoint-B_Mask.gbr, 67keys-trackpoint-B_SilkS.gbr, 67keys-trackpoint-Edge_Cuts.gbr, 67keys-trackpoint-F_Cu.gbr, 67keys-trackpoint-F_Mask.gbr, 67keys-trackpoint-F_SilkS.gbr, 67keys-trackpoint-job.gbrjob]
2021-05-08 Change C89,C90 to 4.7k
    [67keys-trackpoint.sch]
